RouvensLab/Rabbit_Project_v3/URDF_Files/_Compleat_Bunny_replica_v2_light_v5/meshes/Top_v2_1_3dless_com_simplified.stl

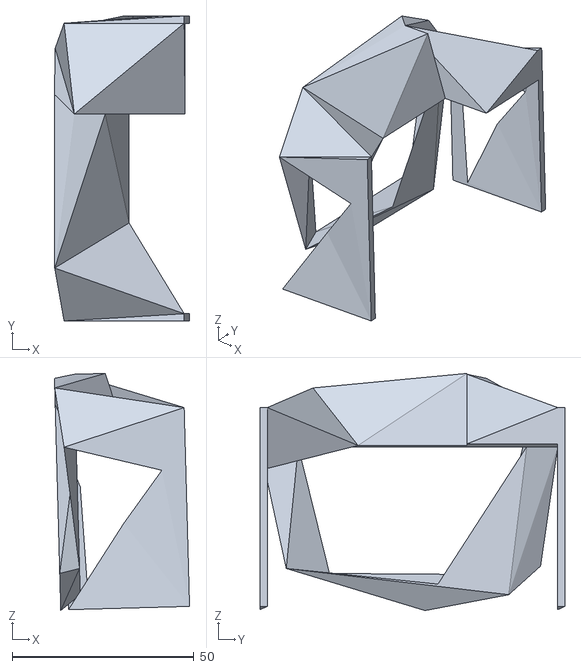
[picture p35: CAD file, 2024-10-12]
URDF_Files/_Compleat_Bunny_replica_v2_light_v5/meshes/Top_v2_1_3dless_com_simplified.stl
37.2 x 84.0 x 65.3
