RouvensLab/Rabbit_Project_v3/URDF_Files/_Compleat_Bunny_replica_v2_light_v5/meshes/GE_27.stl

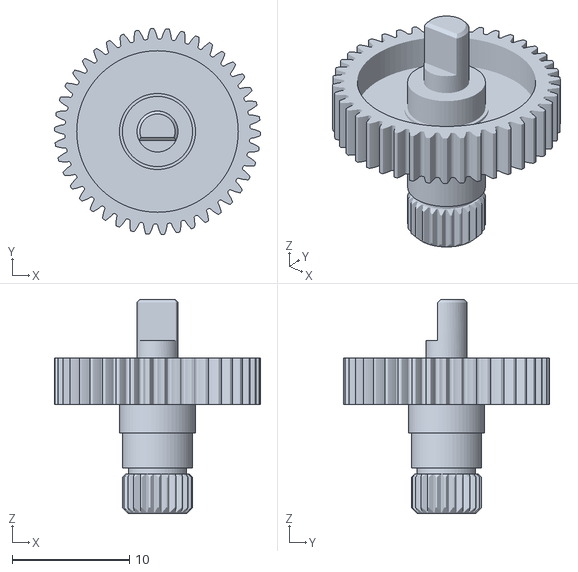
[picture p36: CAD file, 2024-10-12]
URDF_Files/_Compleat_Bunny_replica_v2_light_v5/meshes/GE_27.stl
17.6 x 17.6 x 18.3
