RouvensLab/Rabbit_Project_v3/URDF_Files/_Compleat_Bunny_replica_v2_light_v5/meshes/ST3215 v1.stl

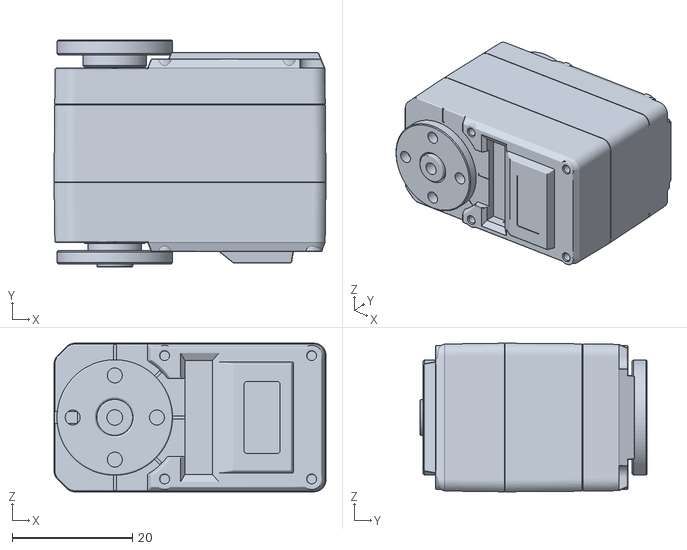
[picture p37: CAD file, 2024-10-12]
URDF_Files/_Compleat_Bunny_replica_v2_light_v5/meshes/ST3215 v1.stl
45.2 x 37.8 x 24.7
