RouvensLab/Rabbit_Project_v3/URDF_Files/_Compleat_Bunny_replica_v2_light_v5/meshes/MOTOR-1723_3(Mirror).stl

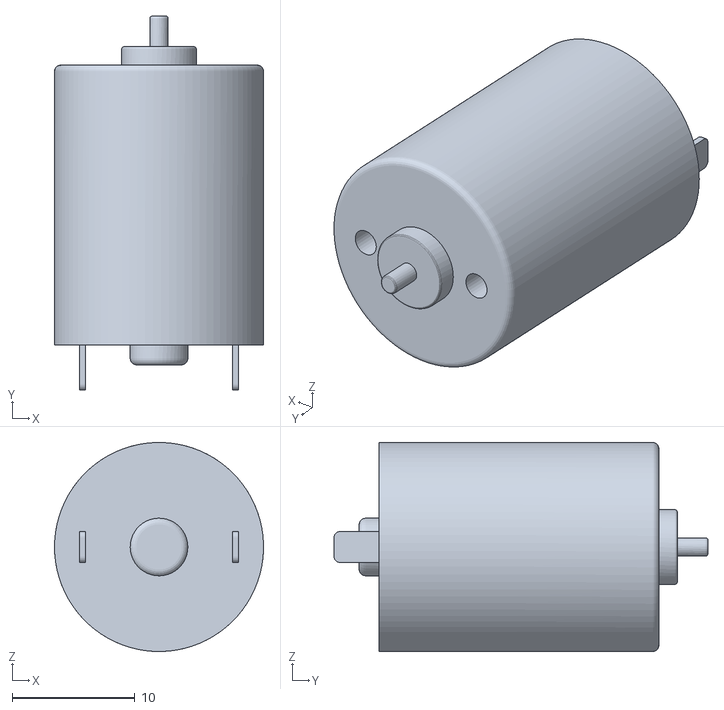
[picture p38: CAD file, 2024-10-12]
URDF_Files/_Compleat_Bunny_replica_v2_light_v5/meshes/MOTOR-1723_3(Mirror).stl
17.0 x 30.5 x 17.0
