RouvensLab/Rabbit_Project_v3/URDF_Files/_Compleat_Bunny_replica_v2_light_v5/meshes/belly_left_v3_1_3dless_com_simplified.stl

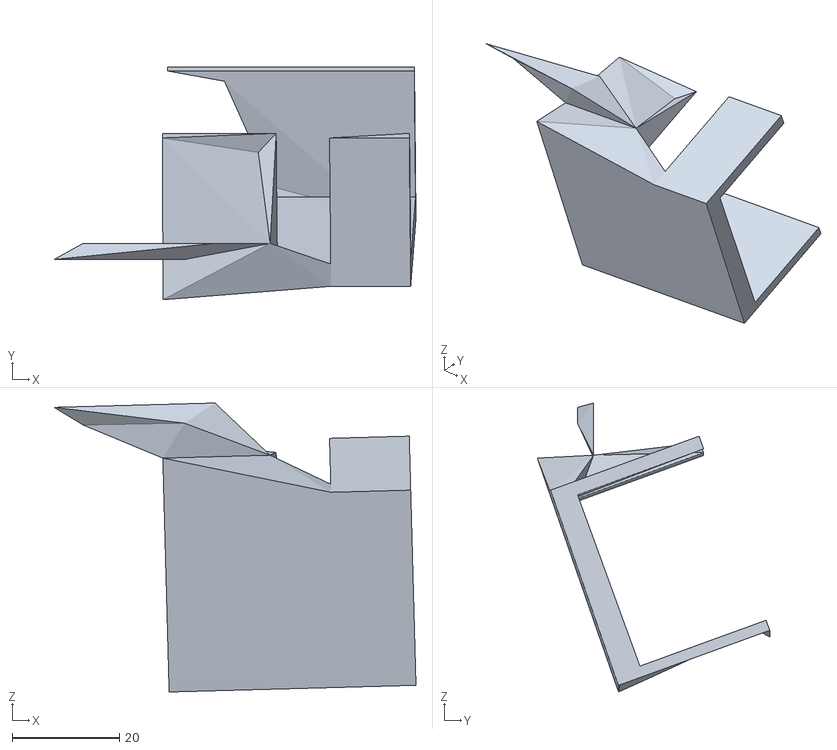
[picture p39: CAD file, 2024-10-12]
URDF_Files/_Compleat_Bunny_replica_v2_light_v5/meshes/belly_left_v3_1_3dless_com_simplified.stl
67.4 x 43.3 x 53.8
