RouvensLab/Rabbit_Project_v3/URDF_Files/_Compleat_Bunny_replica_v2_light_v5/meshes/LegPart4_v1_1.stl

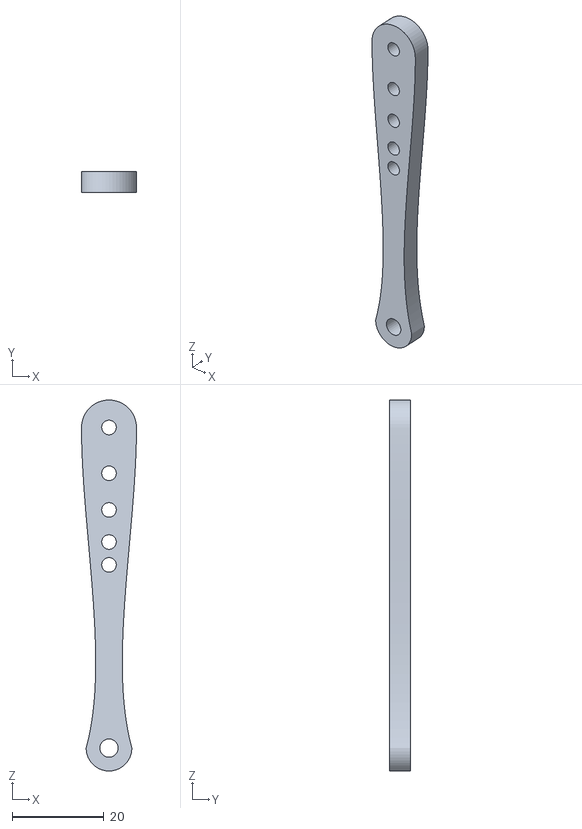
[picture p40: CAD file, 2024-10-12]
URDF_Files/_Compleat_Bunny_replica_v2_light_v5/meshes/LegPart4_v1_1.stl
12.0 x 4.50 x 81.0
