RouvensLab/Rabbit_Project_v3/URDF_Files/_Compleat_Bunny_replica_v2_light_v5/meshes/XG-ZIJI_16.stl

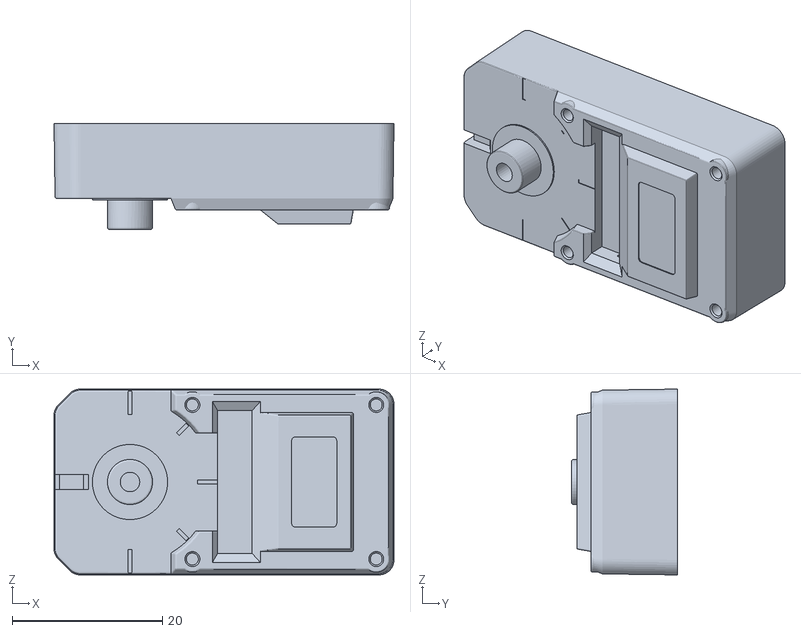
[picture p42: CAD file, 2024-10-12]
URDF_Files/_Compleat_Bunny_replica_v2_light_v5/meshes/XG-ZIJI_16.stl
45.2 x 14.1 x 24.7
