RouvensLab/Rabbit_Project_v3/URDF_Files/_Compleat_Bunny_replica_v2_light_v5/meshes/SG-ZIJI_15(Mirror).stl

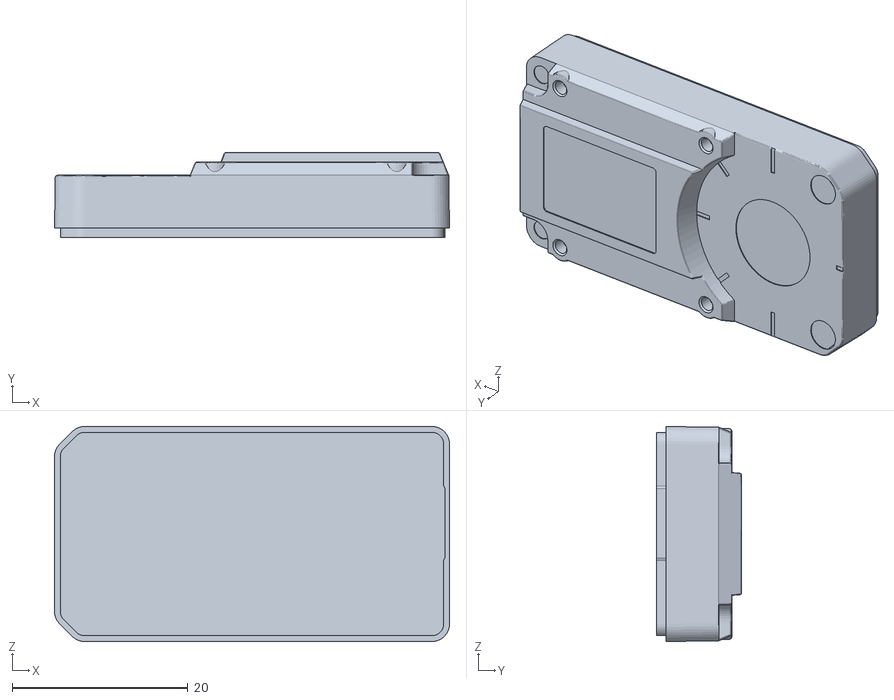
[picture p43: CAD file, 2024-10-12]
URDF_Files/_Compleat_Bunny_replica_v2_light_v5/meshes/SG-ZIJI_15(Mirror).stl
45.0 x 9.70 x 24.5
