RouvensLab/Rabbit_Project_v3/URDF_Files/_Compleat_Bunny_replica_v2_light_v5/meshes/Spine_joint_Component1_v1_1_3dless_com_simplified.stl

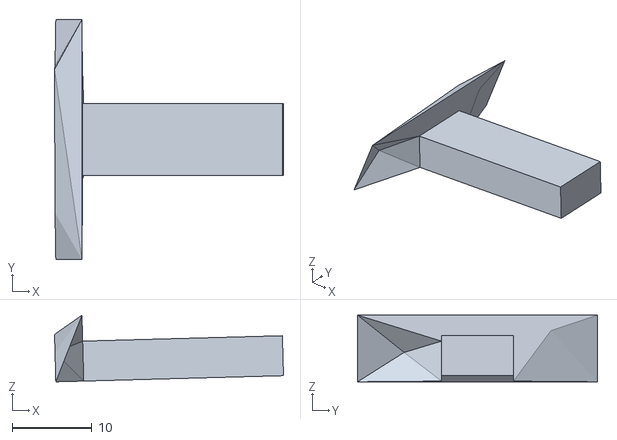
[picture p44: CAD file, 2024-10-12]
URDF_Files/_Compleat_Bunny_replica_v2_light_v5/meshes/Spine_joint_Component1_v1_1_3dless_com_simplified.stl
28.6 x 30.0 x 8.34
