RouvensLab/Rabbit_Project_v3/URDF_Files/_Compleat_Bunny_replica_v2_light_v5/meshes/LegPart2_v1_1.stl

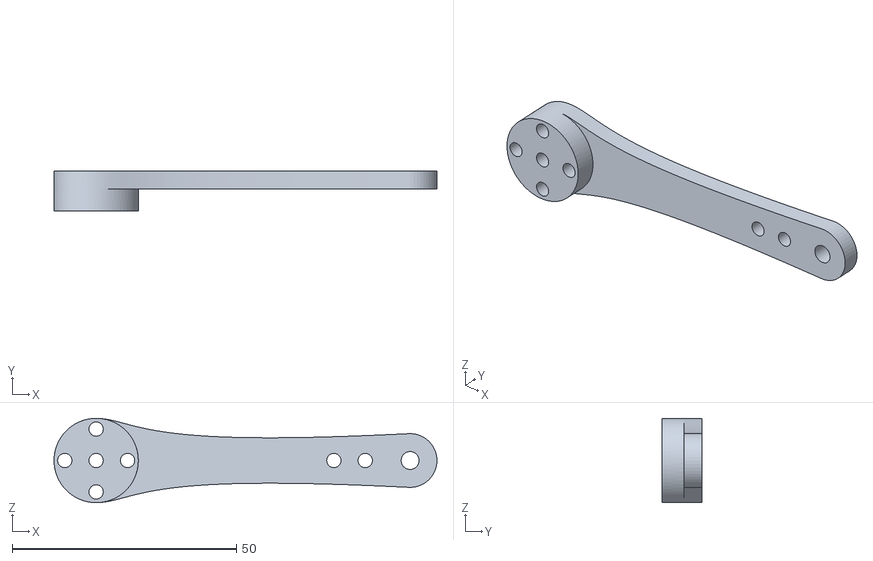
[picture p45: CAD file, 2024-10-12]
URDF_Files/_Compleat_Bunny_replica_v2_light_v5/meshes/LegPart2_v1_1.stl
85.4 x 9.00 x 18.8
