RouvensLab/Rabbit_Project_v3/URDF_Files/_Compleat_Bunny_replica_v2_light_v5/meshes/PCB-CHAZUO_92.stl

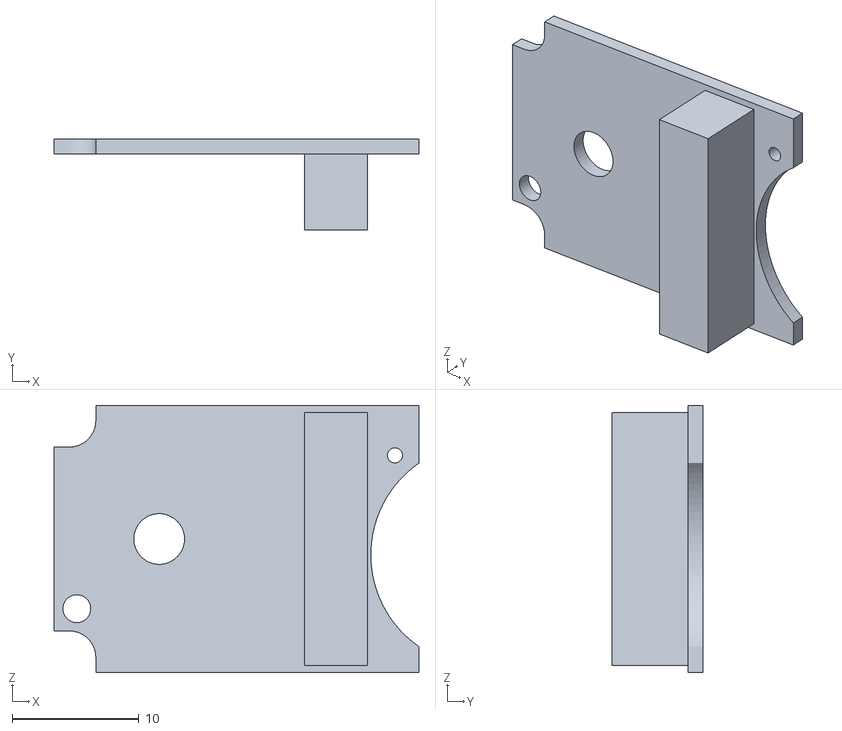
[picture p46: CAD file, 2024-10-12]
URDF_Files/_Compleat_Bunny_replica_v2_light_v5/meshes/PCB-CHAZUO_92.stl
28.8 x 7.20 x 21.1
