RouvensLab/Rabbit_Project_v3/URDF_Files/_Compleat_Bunny_replica_v2_light_v5/meshes/Head_v1_1_3dless_com_simplified.stl

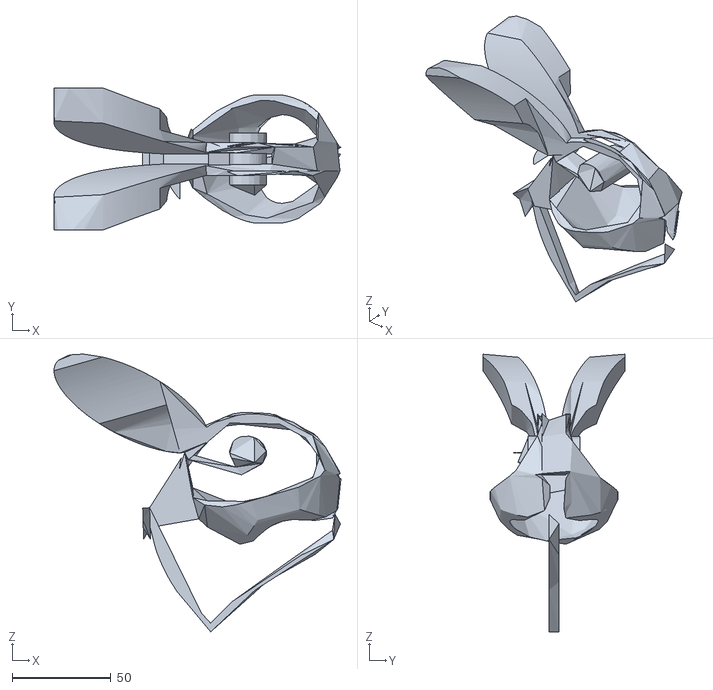
[picture p47: CAD file, 2024-10-12]
URDF_Files/_Compleat_Bunny_replica_v2_light_v5/meshes/Head_v1_1_3dless_com_simplified.stl
145.2 x 72.0 x 140.5
