RouvensLab/Rabbit_Project_v3/URDF_Files/_Compleat_Bunny_replica_v2_light_v5/meshes/Bunny_Bottom_Leg_v1_Mirror__1_3dless_com_simplified.stl

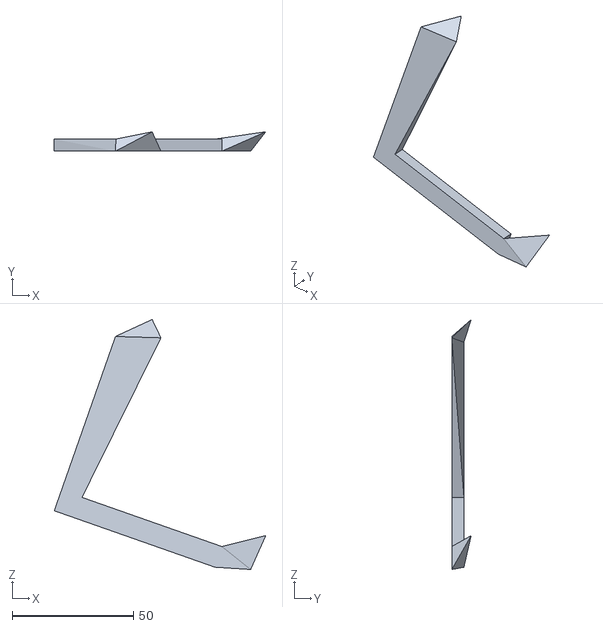
[picture p49: CAD file, 2024-10-12]
URDF_Files/_Compleat_Bunny_replica_v2_light_v5/meshes/Bunny_Bottom_Leg_v1_Mirror__1_3dless_com_simplified.stl
87.4 x 8.00 x 103.2
