RouvensLab/Rabbit_Project_v3/URDF_Files/_Compleat_Bunny_replica_v2_light_v5/meshes/Spine_joint_Component5_v1_1.stl

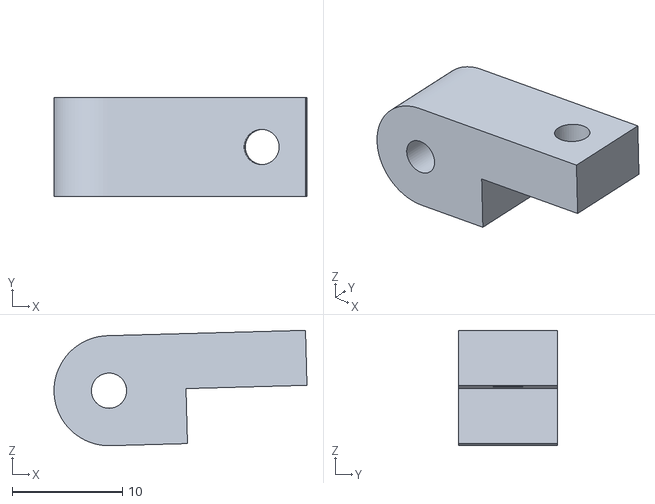
[picture p51: CAD file, 2024-10-12]
URDF_Files/_Compleat_Bunny_replica_v2_light_v5/meshes/Spine_joint_Component5_v1_1.stl
23.0 x 9.00 x 10.5
