RouvensLab/Rabbit_Project_v3/URDF_Files/_Compleat_Bunny_replica_v2_light_v5/meshes/Bunny_Bottom_Leg_v1_Mirror__1.stl

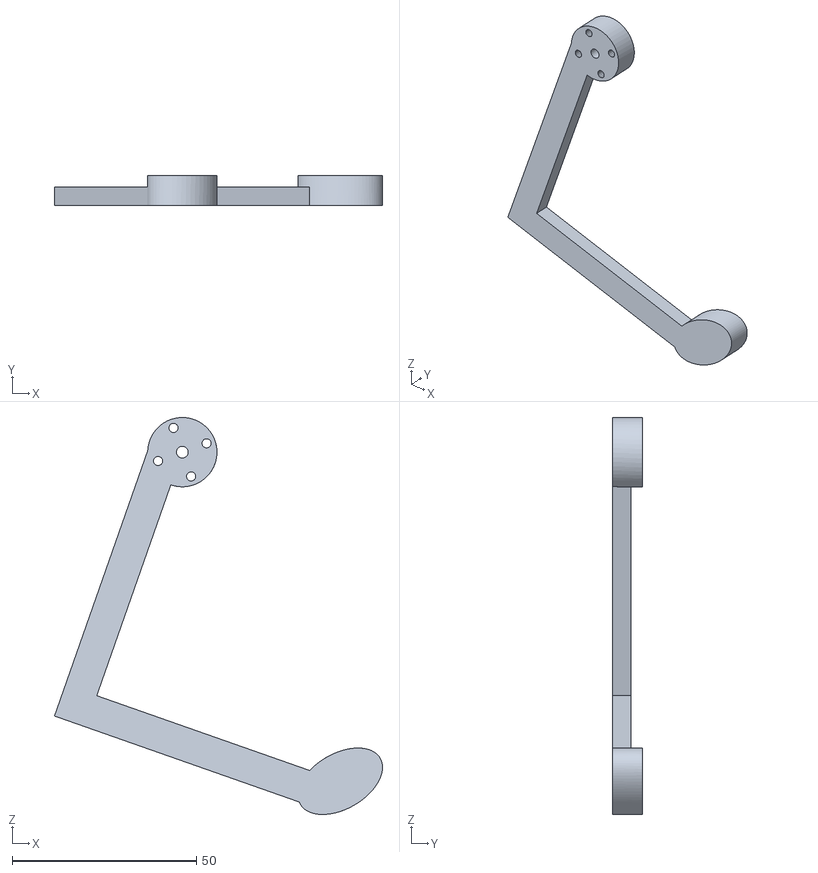
[picture p52: CAD file, 2024-10-12]
URDF_Files/_Compleat_Bunny_replica_v2_light_v5/meshes/Bunny_Bottom_Leg_v1_Mirror__1.stl
89.0 x 8.00 x 107.7
