RouvensLab/Rabbit_Project_v3/URDF_Files/_Compleat_Bunny_replica_v2_light_v5/meshes/_3dless_com_simplified (1).stl

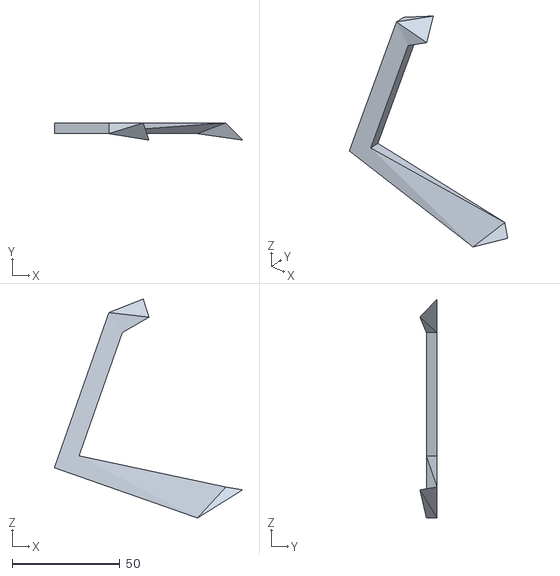
[picture p53: CAD file, 2024-10-12]
URDF_Files/_Compleat_Bunny_replica_v2_light_v5/meshes/_3dless_com_simplified (1).stl
87.4 x 8.00 x 101.6
