RouvensLab/Rabbit_Project_v3/URDF_Files/_Compleat_Bunny_replica_v2_light_v5/meshes/belly_right_v3_1_3dless_com_simplified.stl

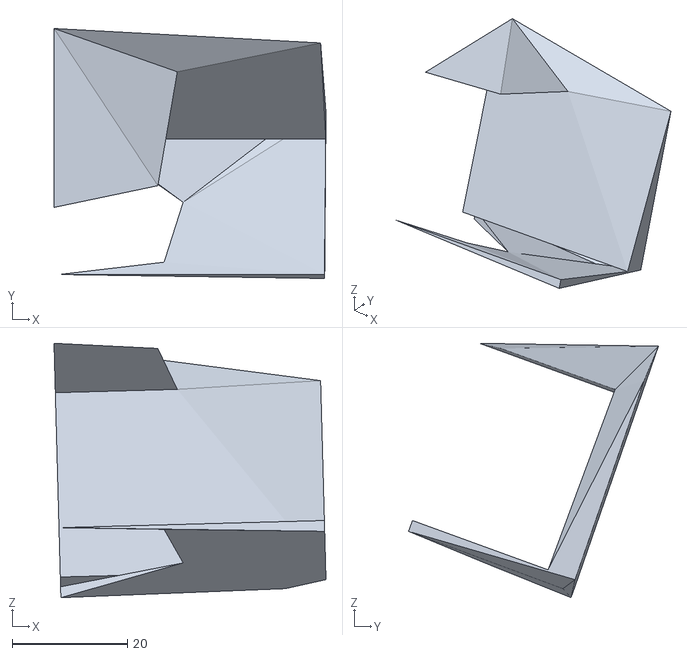
[picture p54: CAD file, 2024-10-12]
URDF_Files/_Compleat_Bunny_replica_v2_light_v5/meshes/belly_right_v3_1_3dless_com_simplified.stl
47.1 x 43.3 x 44.1
