RouvensLab/Rabbit_Project_v3/URDF_Files/_Compleat_Bunny_replica_v2_light_v5/meshes/金属舵盘（从动） v2(Mirror).stl

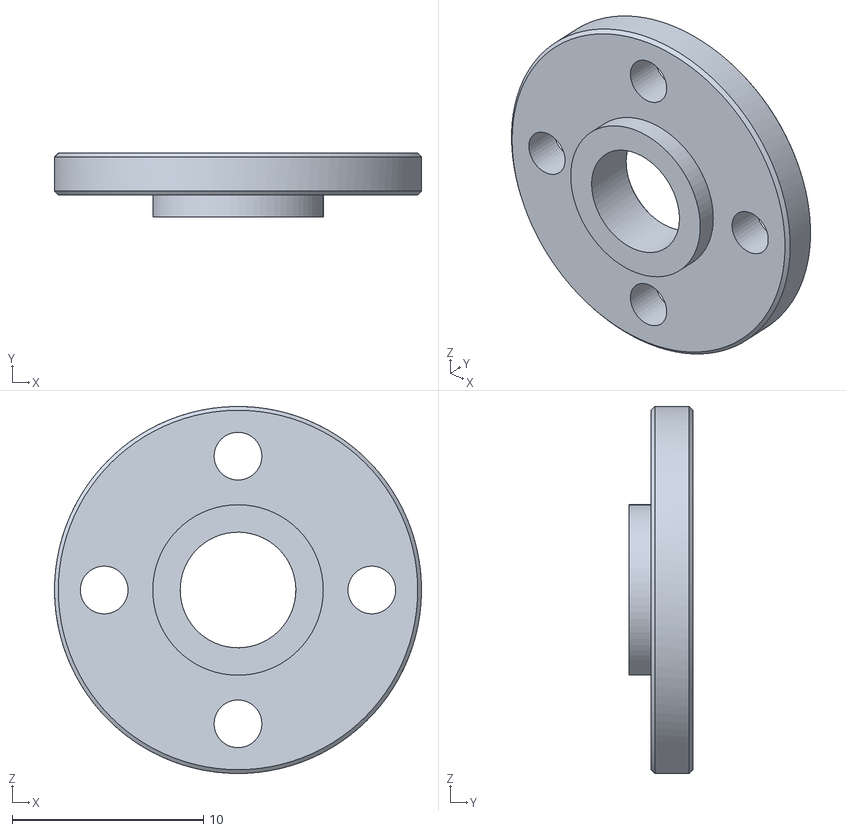
[picture p55: CAD file, 2024-10-12]
URDF_Files/_Compleat_Bunny_replica_v2_light_v5/meshes/金属舵盘（从动） v2(Mirror).stl
19.2 x 3.35 x 19.2
