RouvensLab/Rabbit_Project_v3/URDF_Files/_Compleat_Bunny_replica_v2_light_v5/meshes/Spine_joint_Component6_v1_1.stl

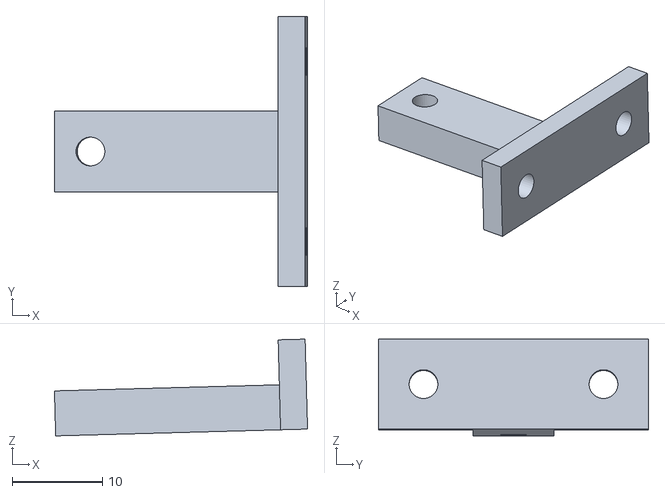
[picture p56: CAD file, 2024-10-12]
URDF_Files/_Compleat_Bunny_replica_v2_light_v5/meshes/Spine_joint_Component6_v1_1.stl
28.1 x 30.0 x 10.8
