RouvensLab/Rabbit_Project_v3/URDF_Files/_Compleat_Bunny_replica_v2_light_v5/meshes/Bunny_Bottom_v2_v2_1_3dless_com_simplified.stl

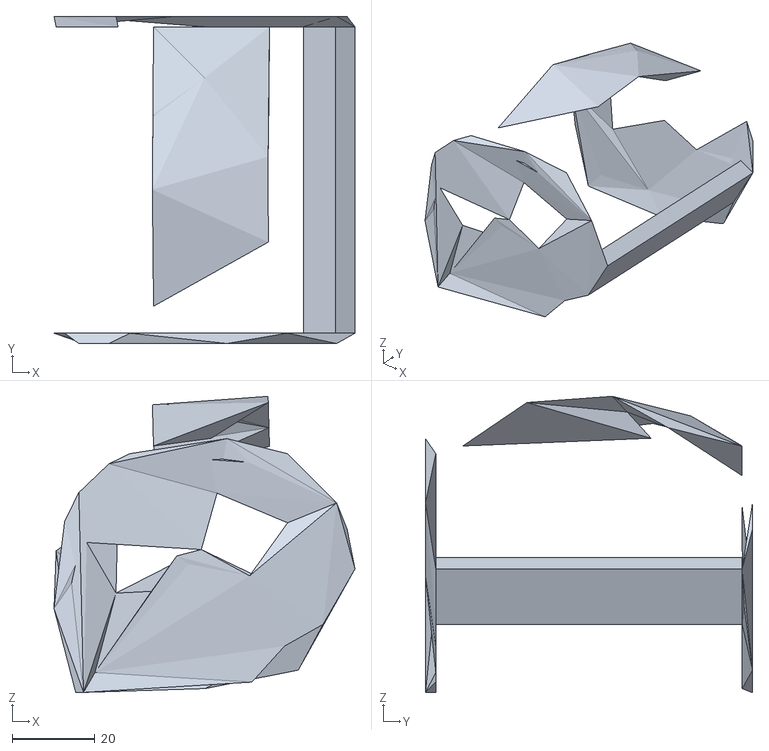
[picture p58: CAD file, 2024-10-12]
URDF_Files/_Compleat_Bunny_replica_v2_light_v5/meshes/Bunny_Bottom_v2_v2_1_3dless_com_simplified.stl
72.7 x 79.0 x 71.6
