RouvensLab/Rabbit_Project_v3/URDF_Files/_Compleat_Bunny_replica_v2_light_v5/meshes/LegPart4_v1_1_3dless_com_simplified.stl

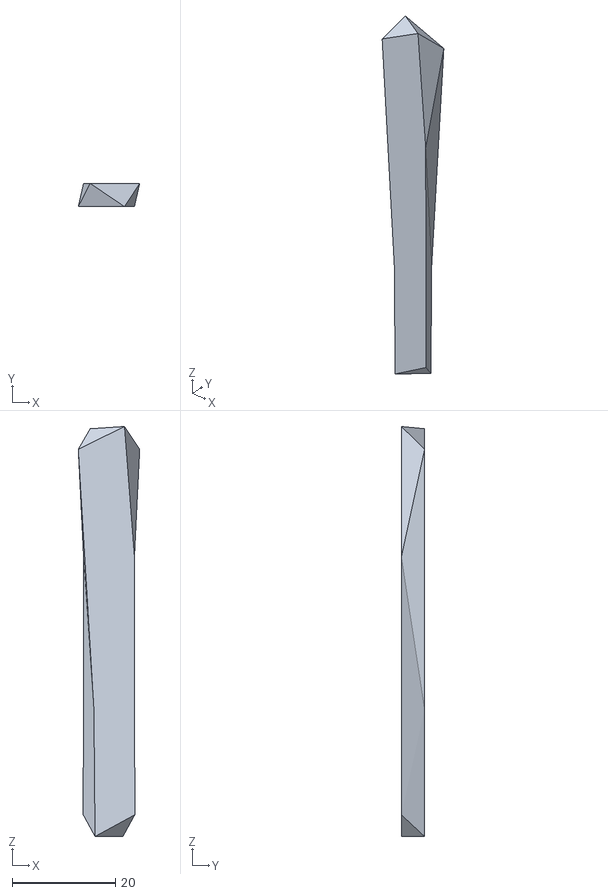
[picture p60: CAD file, 2024-10-12]
URDF_Files/_Compleat_Bunny_replica_v2_light_v5/meshes/LegPart4_v1_1_3dless_com_simplified.stl
11.9 x 4.50 x 79.4
