RouvensLab/Rabbit_Project_v3/URDF_Files/_Compleat_Bunny_replica_v2_light_v5/meshes/Bunny_Bottom_v2_v2_1.stl

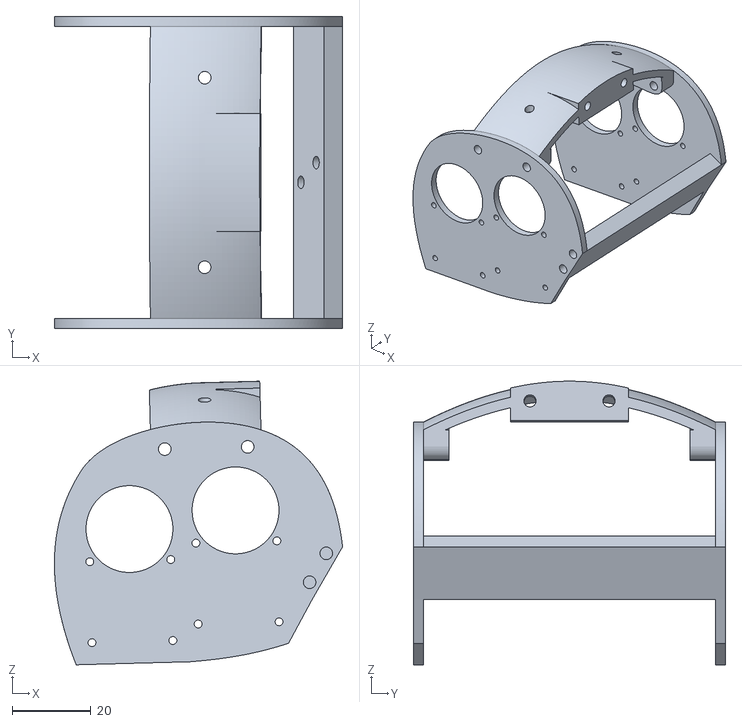
[picture p61: CAD file, 2024-10-12]
URDF_Files/_Compleat_Bunny_replica_v2_light_v5/meshes/Bunny_Bottom_v2_v2_1.stl
73.0 x 79.0 x 71.8
