RouvensLab/Rabbit_Project_v3/URDF_Files/_Compleat_Bunny_replica_v2_light_v5/meshes/金属舵盘（驱动） v2.stl

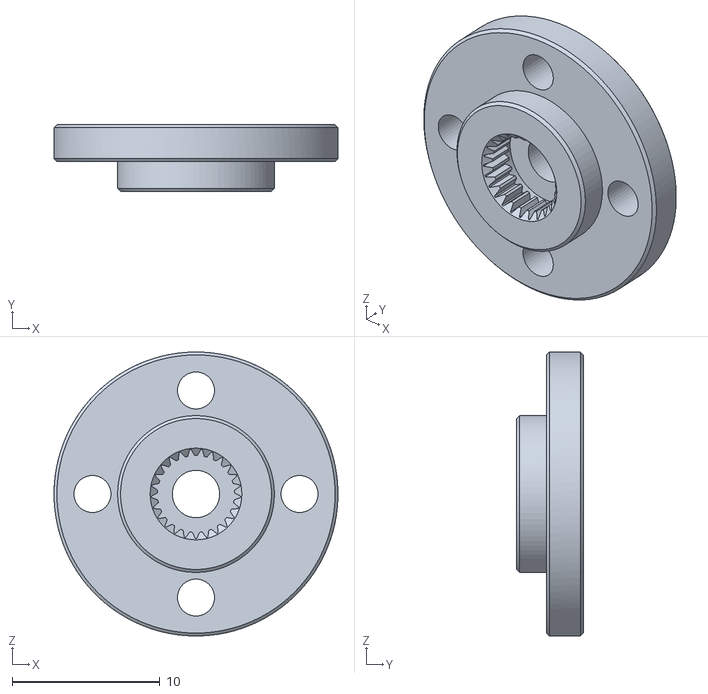
[picture p64: CAD file, 2024-10-12]
URDF_Files/_Compleat_Bunny_replica_v2_light_v5/meshes/金属舵盘（驱动） v2.stl
19.2 x 4.50 x 19.2
