RouvensLab/Rabbit_Project_v3/URDF_Files/_Compleat_Bunny_replica_v2_light_v5/meshes/base_link_3dless_com_simplified.stl

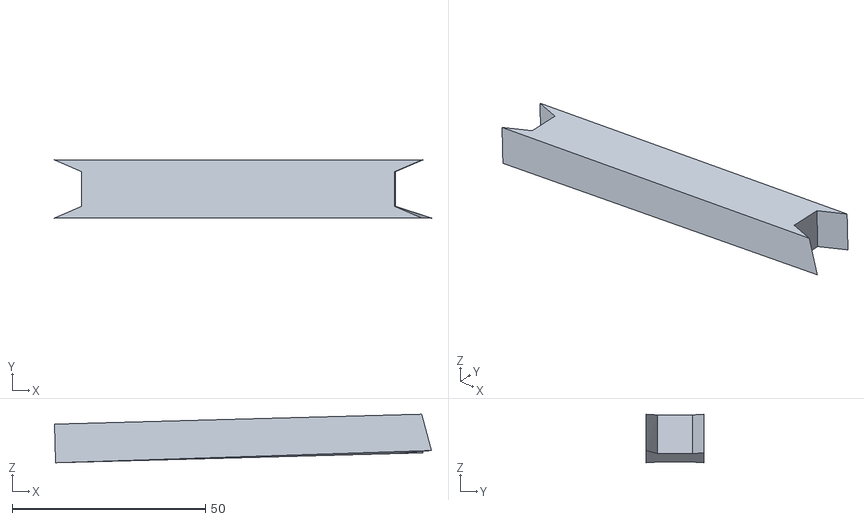
[picture p67: CAD file, 2024-10-12]
URDF_Files/_Compleat_Bunny_replica_v2_light_v5/meshes/base_link_3dless_com_simplified.stl
97.5 x 15.0 x 12.6
