RouvensLab/Rabbit_Project_v3/URDF_Files/_Compleat_Bunny_replica_v2_light_v5/meshes/LegPartFoot_v1_1.stl

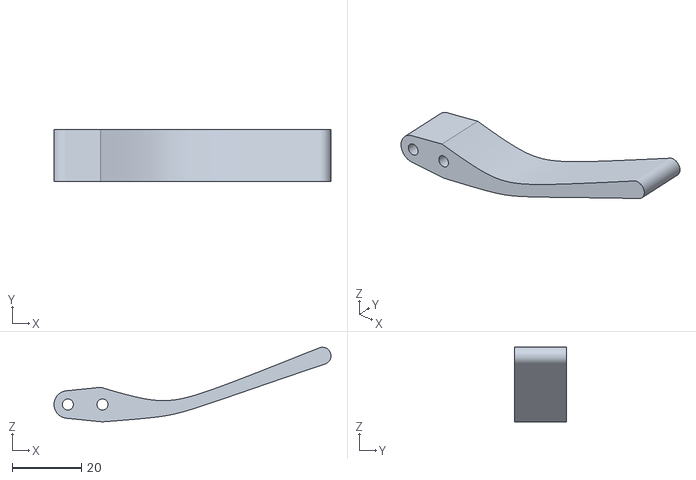
[picture p68: CAD file, 2024-10-12]
URDF_Files/_Compleat_Bunny_replica_v2_light_v5/meshes/LegPartFoot_v1_1.stl
80.0 x 15.0 x 21.6
