RouvensLab/Rabbit_Project_v3/URDF_Files/_Compleat_Bunny_replica_v2_light_v5/meshes/LegPart2_v1__1__1_3dless_com_simplified.stl

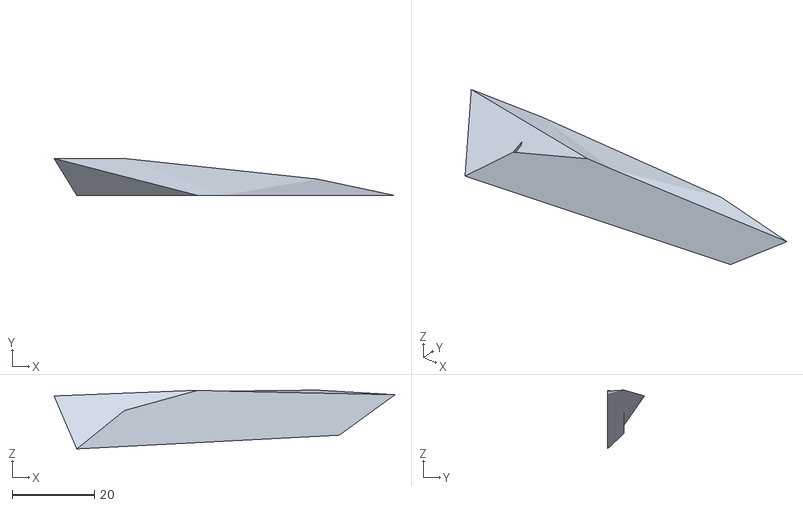
[picture p70: CAD file, 2024-10-12]
URDF_Files/_Compleat_Bunny_replica_v2_light_v5/meshes/LegPart2_v1__1__1_3dless_com_simplified.stl
82.8 x 9.00 x 14.3
