RouvensLab/Rabbit_Project_v3/(list of files, cad)

Other CAD files:
URDF_Files/_Compleat_Bunny_replica_v2_light_v5/meshes/GE_27(Mirror).stl
URDF_Files/_Compleat_Bunny_replica_v2_light_v5/meshes/ST3215 Servo v2(Mirror).stl
URDF_Files/_Compleat_Bunny_replica_v2_light_v5/meshes/ST3215 v1(Mirror).stl
URDF_Files/_Compleat_Bunny_replica_v2_light_v5/meshes/LegPart2_v1__1__1.stl
URDF_Files/_Compleat_Bunny_replica_v2_light_v5/meshes/ZK_122(Mirror).stl
URDF_Files/_Compleat_Bunny_replica_v2_light_v5/meshes/belly_left_v3_1.stl
URDF_Files/_Compleat_Bunny_replica_v2_light_v5/meshes/LegPart4_v1__1__1.stl
URDF_Files/_Compleat_Bunny_replica_v2_light_v5/meshes/Spine_joint_Component3_v1_1.stl
URDF_Files/_Compleat_Bunny_replica_v2_light_v5/meshes/Bunny_Bottom_Leg_v1_1.stl
URDF_Files/_Compleat_Bunny_replica_v2_light_v5/meshes/金属舵盘（从动） v2.stl
URDF_Files/_Compleat_Bunny_replica_v2_light_v5/meshes/XG-ZIJI_16(Mirror).stl
URDF_Files/_Compleat_Bunny_replica_v2_light_v5/meshes/金属舵盘（驱动） v2(Mirror).stl
URDF_Files/_Compleat_Bunny_replica_v2_light_v5/meshes/PCB-CHAZUO_92(Mirror).stl
URDF_Files/_Compleat_Bunny_replica_v2_light_v5/meshes/MOTOR-1723_3.stl
URDF_Files/_Compleat_Bunny_replica_v2_light_v5/meshes/Spine_joint_Component6_v1_1_3dless_com_simplified.stl
URDF_Files/_Compleat_Bunny_replica_v2_light_v5/meshes/LegPartFoot_v1__1__1.stl
URDF_Files/_Compleat_Bunny_replica_v2_light_v5/meshes/SG-ZIJI_15.stl
URDF_Files/_Compleat_Bunny_replica_v2_light_v5/meshes/MOTOR-1723_3 (1).stl
URDF_Files/_Compleat_Bunny_replica_v2_light_v5/meshes/MOTOR-1723_3 (2).stl
URDF_Files/_Compleat_Bunny_replica_v2_light_v5/meshes/MOTOR-1723_3 (3).stl
URDF_Files/_Compleat_Bunny_replica_v2_light_v5/meshes/MOTOR-1723_3 (4).stl
URDF_Files/_Compleat_Bunny_replica_v2_light_v5/meshes/MOTOR-1723_3 (5).stl
URDF_Files/_Compleat_Bunny_replica_v2_light_v5/meshes/MOTOR-1723_3 (6).stl
URDF_Files/_Compleat_Bunny_replica_v2_light_v5/meshes/SG-ZIJI_15 (1).stl
URDF_Files/_Compleat_Bunny_replica_v2_light_v5/meshes/SG-ZIJI_15 (2).stl
URDF_Files/_Compleat_Bunny_replica_v2_light_v5/meshes/SG-ZIJI_15 (3).stl
URDF_Files/_Compleat_Bunny_replica_v2_light_v5/meshes/SG-ZIJI_15 (4).stl
URDF_Files/_Compleat_Bunny_replica_v2_light_v5/meshes/SG-ZIJI_15 (5).stl
URDF_Files/_Compleat_Bunny_replica_v2_light_v5/meshes/SG-ZIJI_15 (6).stl
URDF_Files/_Compleat_Bunny_replica_v2_light_v5/meshes/金属舵盘（从动） v2 (1).stl
URDF_Files/_Compleat_Bunny_replica_v2_light_v5/meshes/金属舵盘（从动） v2 (2).stl
URDF_Files/_Compleat_Bunny_replica_v2_light_v5/meshes/金属舵盘（从动） v2 (3).stl
URDF_Files/_Compleat_Bunny_replica_v2_light_v5/meshes/金属舵盘（从动） v2 (4).stl
URDF_Files/_Compleat_Bunny_replica_v2_light_v5/meshes/金属舵盘（从动） v2 (5).stl
URDF_Files/_Compleat_Bunny_replica_v2_light_v5/meshes/金属舵盘（从动） v2 (6).stl
